Otto17/Portable_Fan/Photo/Photo2.jpg

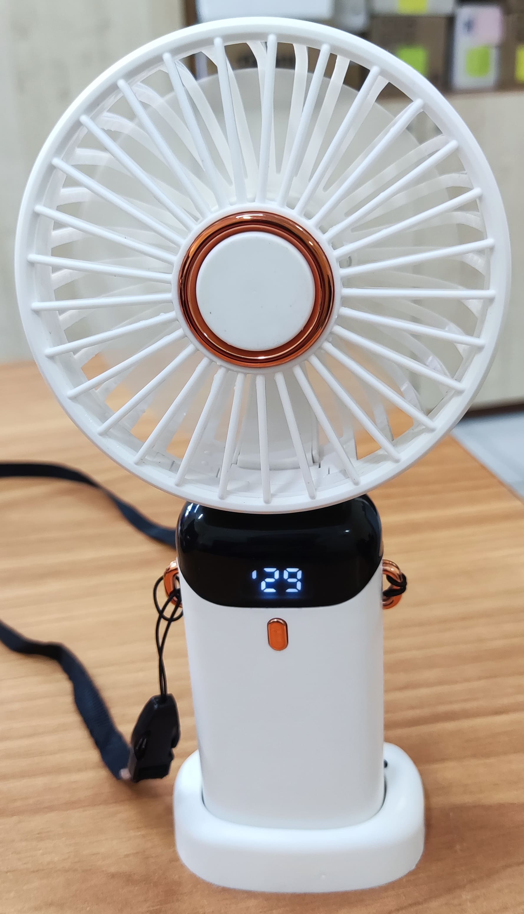
Photo/Photo2.jpg
