Otto17/Portable_Fan/Photo/Photo3.jpg

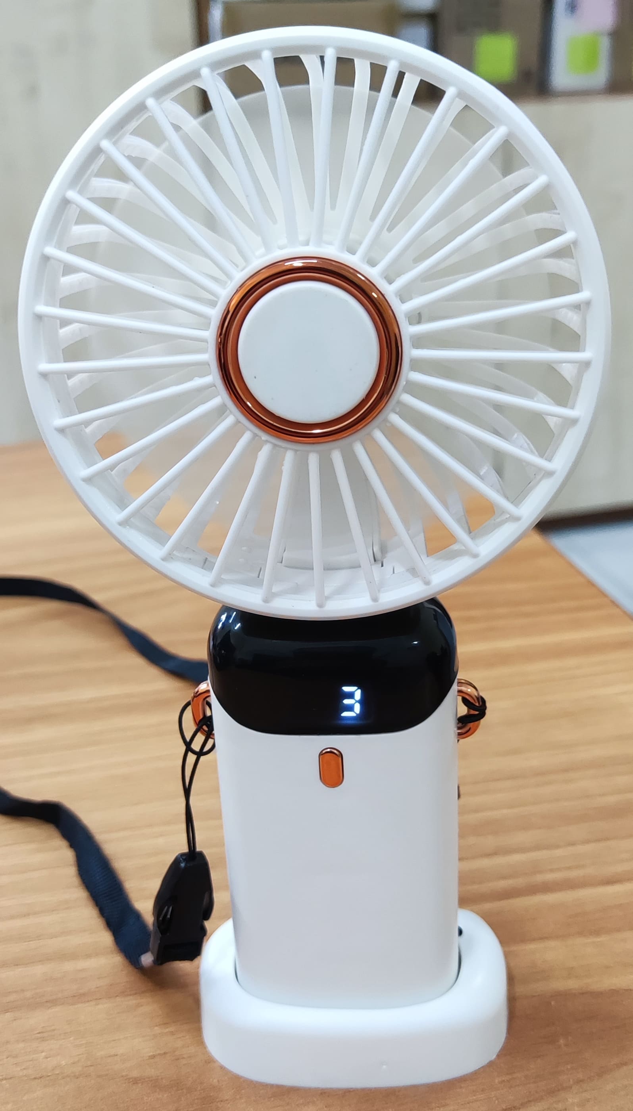
Photo/Photo3.jpg
