Otto17/Portable_Fan/Photo/Photo4.jpg

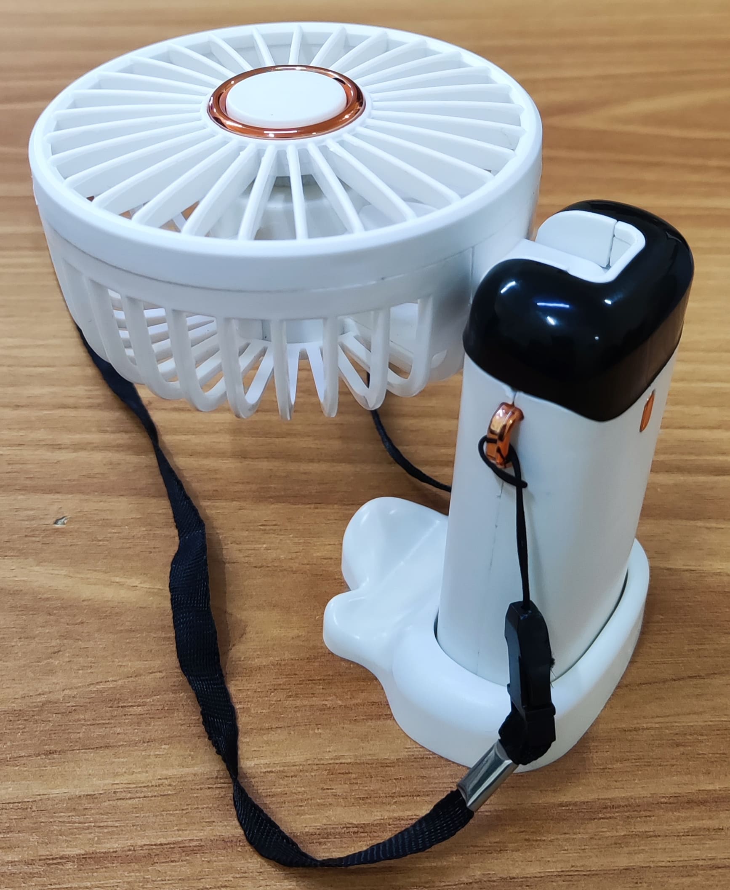
Photo/Photo4.jpg
