Otto17/Portable_Fan/Photo/Photo5.jpg

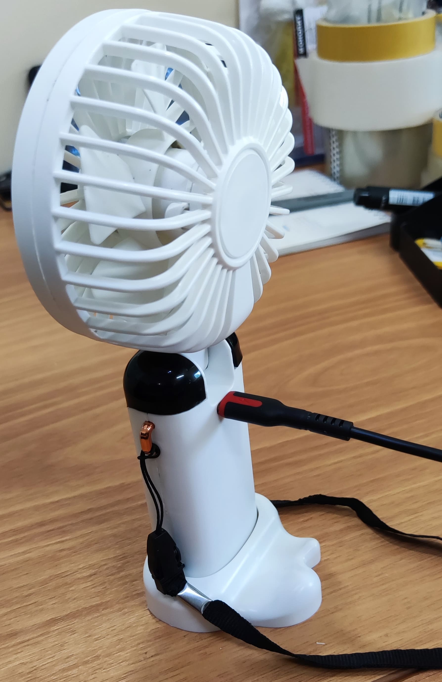
Photo/Photo5.jpg
