Otto17/Portable_Fan/Photo/Photo7.jpg

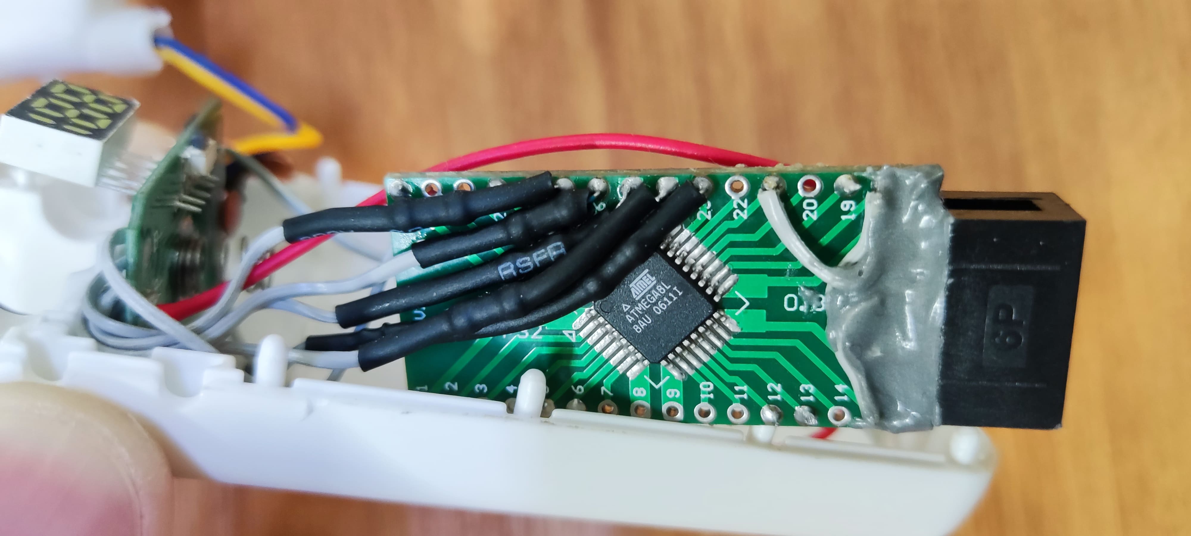
Photo/Photo7.jpg
