Otto17/Portable_Fan/Photo/Photo8.jpg

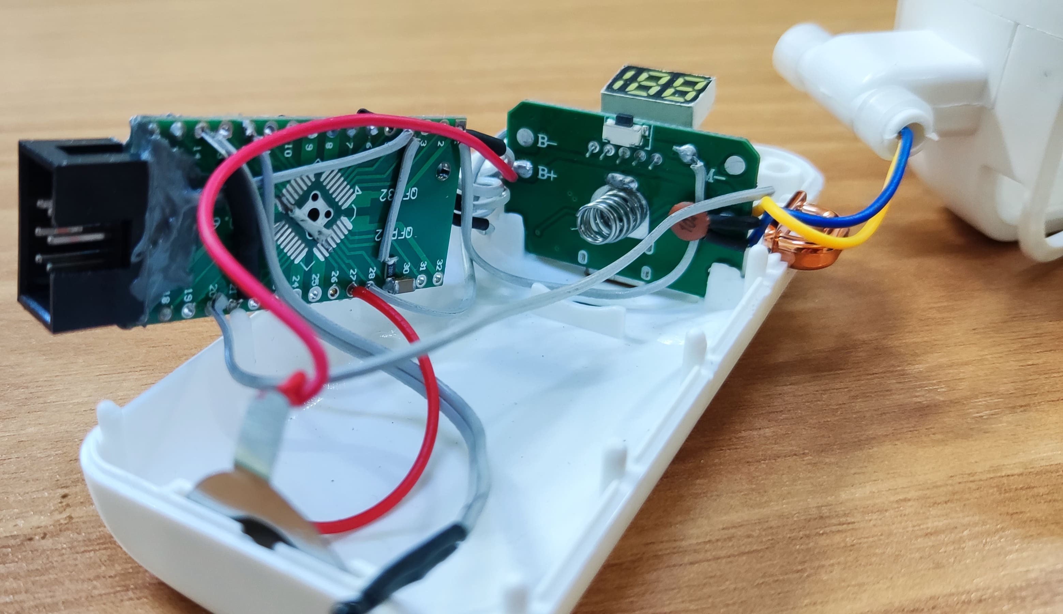
Photo/Photo8.jpg
