Otto17/Portable_Fan/Photo/Photo9.jpg

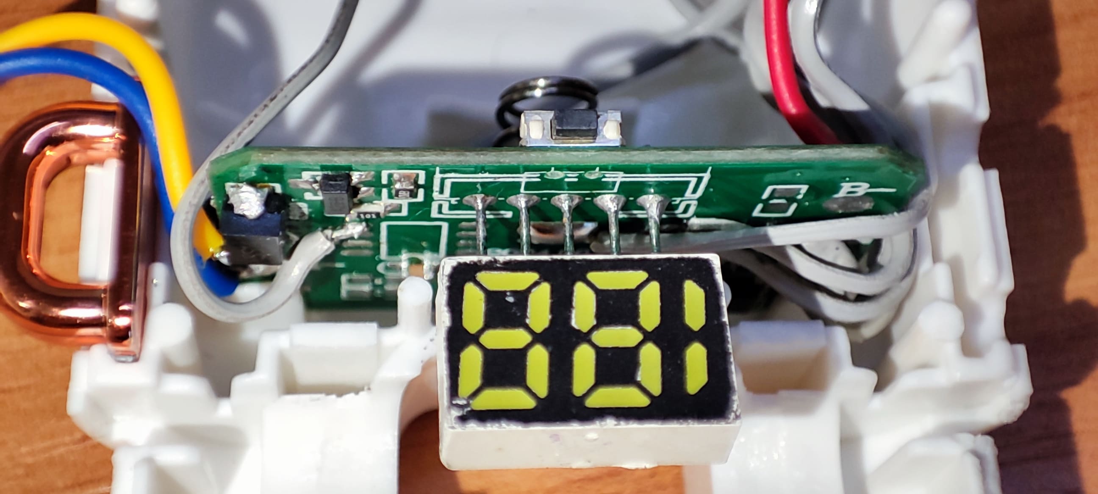
Photo/Photo9.jpg
