Otto17/Portable_Fan/Photo/Photo10.jpg

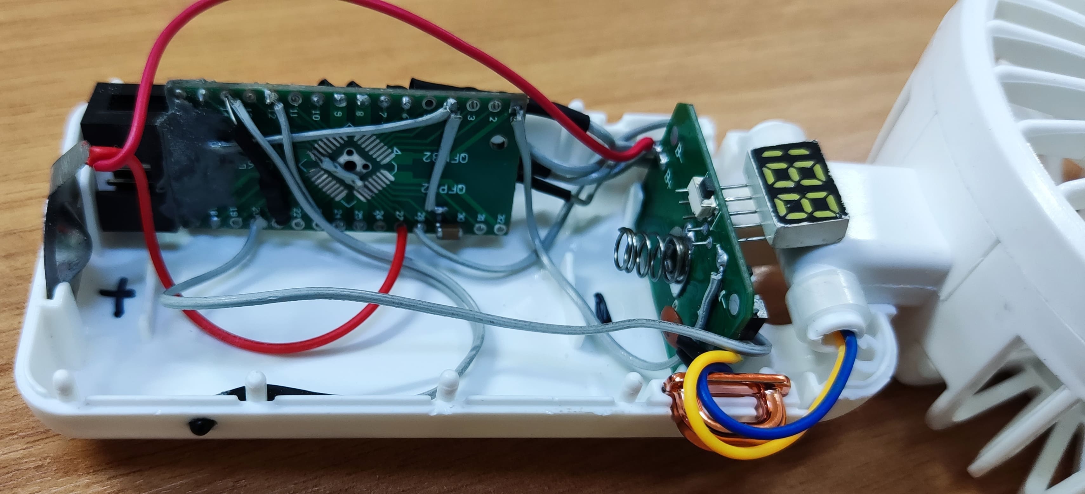
Photo/Photo10.jpg
